mabiran/environode-wl55/CM0/EnviroNode_CM0PLUS/LoRaWAN/App/lora_app.c

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

/* Includes ------------------------------------------------------------------*/
#include "platform.h"
#include "sys_app.h"
#include "lora_app.h"
#include "stm32_seq.h"
#include "stm32_timer.h"
#include "utilities_def.h"
#include "app_version.h"
#include "lorawan_version.h"
#include "subghz_phy_version.h"
#include "lora_info.h"
#include "LmHandler.h"
#include "adc_if.h"
#include "CayenneLpp.h"
#include "sys_sensors.h"
#include "flash_if.h"

/* USER CODE BEGIN Includes */
#include "korero_mailbox.h"
/* USER CODE END Includes */

/* External variables ---------------------------------------------------------*/
/**
  * @brief LoRa State Machine states
  */
typedef enum TxEventType_e
{
  /**
    * @brief Appdata Transmission issue based on timer every TxDutyCycleTime
    */
  TX_ON_TIMER,
  /**
    * @brief Appdata Transmission external event plugged on OnSendEvent( )
    */
  TX_ON_EVENT
} TxEventType_t;

/**
  * LEDs period value of the timer in ms
  */
#define LED_PERIOD_TIME 500

/**
  * Join switch period value of the timer in ms
  */
#define JOIN_TIME 2000

/*---------------------------------------------------------------------------*/
/*                             LoRaWAN NVM configuration                     */
/*---------------------------------------------------------------------------*/
/**
  * @brief LoRaWAN NVM Flash address
  * @note last 2 sector of a 128kBytes device
  */
#define LORAWAN_NVM_BASE_ADDRESS                    ((void *)0x0803F000UL)

/* USER CODE BEGIN PD */
static const char *slotStrings[] = { "1", "2", "C", "C_MC", "P", "P_MC" };
/* USER CODE END PD */

/**
  * @brief  LoRa End Node send request
  */
static void SendTxData(void);

/**
  * @brief  TX timer callback function
  * @param  context ptr of timer context
  */
static void OnTxTimerEvent(void *context);

/**
  * @brief  join event callback function
  * @param  joinParams status of join
  */
static void OnJoinRequest(LmHandlerJoinParams_t *joinParams);

/**
  * @brief callback when LoRaWAN application has sent a frame
  * @brief  tx event callback function
  * @param  params status of last Tx
  */
static void OnTxData(LmHandlerTxParams_t *params);

/**
  * @brief callback when LoRaWAN application has received a frame
  * @param appData data received in the last Rx
  * @param params status of last Rx
  */
static void OnRxData(LmHandlerAppData_t *appData, LmHandlerRxParams_t *params);

/**
  * @brief callback when LoRaWAN Beacon status is updated
  * @param params status of Last Beacon
  */
static void OnBeaconStatusChange(LmHandlerBeaconParams_t *params);

/**
  * @brief callback when system time has been updated
  */
static void OnSysTimeUpdate(void);

/**
  * @brief callback when LoRaWAN application Class is changed
  * @param deviceClass new class
  */
static void OnClassChange(DeviceClass_t deviceClass);

/**
  * @brief  LoRa store context in Non Volatile Memory
  */
static void StoreContext(void);

/**
  * @brief  stop current LoRa execution to switch into non default Activation mode
  */
static void StopJoin(void);

/**
  * @brief  Join switch timer callback function
  * @param  context ptr of Join switch context
  */
static void OnStopJoinTimerEvent(void *context);

/**
  * @brief  Notifies the upper layer that the NVM context has changed
  * @param  state Indicates if we are storing (true) or restoring (false) the NVM context
  */
static void OnNvmDataChange(LmHandlerNvmContextStates_t state);

/**
  * @brief  Store the NVM Data context to the Flash
  * @param  nvm ptr on nvm structure
  * @param  nvm_size number of data bytes which were stored
  */
static void OnStoreContextRequest(void *nvm, uint32_t nvm_size);

/**
  * @brief  Restore the NVM Data context from the Flash
  * @param  nvm ptr on nvm structure
  * @param  nvm_size number of data bytes which were restored
  */
static void OnRestoreContextRequest(void *nvm, uint32_t nvm_size);

/**
  * Will be called each time a Radio IRQ is handled by the MAC layer
  *
  */
static void OnMacProcessNotify(void);

/**
  * @brief Change the periodicity of the uplink frames
  * @param periodicity uplink frames period in ms
  * @note Compliance test protocol callbacks
  */
static void OnTxPeriodicityChanged(uint32_t periodicity);

/**
  * @brief Change the confirmation control of the uplink frames
  * @param isTxConfirmed Indicates if the uplink requires an acknowledgement
  * @note Compliance test protocol callbacks
  */
static void OnTxFrameCtrlChanged(LmHandlerMsgTypes_t isTxConfirmed);

/**
  * @brief Change the periodicity of the ping slot frames
  * @param pingSlotPeriodicity ping slot frames period in ms
  * @note Compliance test protocol callbacks
  */
static void OnPingSlotPeriodicityChanged(uint8_t pingSlotPeriodicity);

/**
  * @brief Will be called to reset the system
  * @note Compliance test protocol callbacks
  */
static void OnSystemReset(void);

/* USER CODE BEGIN PFP */

/**
  * @brief  LED Tx timer callback function
  * @param  context ptr of LED context
  */
static void OnTxTimerLedEvent(void *context);

/**
  * @brief  LED Rx timer callback function
  * @param  context ptr of LED context
  */
static void OnRxTimerLedEvent(void *context);

/**
  * @brief  LED Join timer callback function
  * @param  context ptr of LED context
  */
static void OnJoinTimerLedEvent(void *context);

/**
  * @brief  Periodic poll of the CM4<->CM0+ mailbox; schedules an uplink of the
  *         payload supplied by the CM4 application core.
  * @param  context unused
  */
static void OnMailboxPollTimer(void *context);
static void ProvisionKeys(void);
static void Korero_PublishDevEUI(void);   /* publish DevEUI to mailbox for CM4 */

/* USER CODE END PFP */

/**
  * @brief LoRaWAN default activation type
  */
static ActivationType_t ActivationType = LORAWAN_DEFAULT_ACTIVATION_TYPE;

/**
  * @brief LoRaWAN force rejoin even if the NVM context is restored
  */
static bool ForceRejoin = LORAWAN_FORCE_REJOIN_AT_BOOT;

/**
  * @brief LoRaWAN handler Callbacks
  */
static LmHandlerCallbacks_t LmHandlerCallbacks =
{
  .GetBatteryLevel =              GetBatteryLevel,
  .GetTemperature =               GetTemperatureLevel,
  .GetUniqueId =                  GetUniqueId,
  .GetDevAddr =                   GetDevAddr,
  .OnRestoreContextRequest =      OnRestoreContextRequest,
  .OnStoreContextRequest =        OnStoreContextRequest,
  .OnMacProcess =                 OnMacProcessNotify,
  .OnNvmDataChange =              OnNvmDataChange,
  .OnJoinRequest =                OnJoinRequest,
  .OnTxData =                     OnTxData,
  .OnRxData =                     OnRxData,
  .OnBeaconStatusChange =         OnBeaconStatusChange,
  .OnSysTimeUpdate =              OnSysTimeUpdate,
  .OnClassChange =                OnClassChange,
  .OnTxPeriodicityChanged =       OnTxPeriodicityChanged,
  .OnTxFrameCtrlChanged =         OnTxFrameCtrlChanged,
  .OnPingSlotPeriodicityChanged = OnPingSlotPeriodicityChanged,
  .OnSystemReset =                OnSystemReset,
};

/**
  * @brief LoRaWAN handler parameters
  */
static LmHandlerParams_t LmHandlerParams =
{
  .ActiveRegion =             ACTIVE_REGION,
  .DefaultClass =             LORAWAN_DEFAULT_CLASS,
  .AdrEnable =                LORAWAN_ADR_STATE,
  .IsTxConfirmed =            LORAWAN_DEFAULT_CONFIRMED_MSG_STATE,
  .TxDatarate =               LORAWAN_DEFAULT_DATA_RATE,
  .TxPower =                  LORAWAN_DEFAULT_TX_POWER,
  .PingSlotPeriodicity =      LORAWAN_DEFAULT_PING_SLOT_PERIODICITY,
  .RxBCTimeout =              LORAWAN_DEFAULT_CLASS_B_C_RESP_TIMEOUT
};

/**
  * @brief Type of Event to generate application Tx
  */
/* KoreroNet: event-driven, NOT periodic. Uplinks are triggered by Pi commands
   relayed from CM4 via the shared mailbox (see OnMailboxPollTimer), not a timer. */
static TxEventType_t EventType = TX_ON_EVENT;

/**
  * @brief Timer to handle the application Tx
  */
static UTIL_TIMER_Object_t TxTimer;

/**
  * @brief Tx Timer period
  */
static UTIL_TIMER_Time_t TxPeriodicity = APP_TX_DUTYCYCLE;

/**
  * @brief Join Timer period
  */
static UTIL_TIMER_Object_t StopJoinTimer;

/* USER CODE BEGIN PV */
/**
  * @brief User application buffer
  */
static uint8_t AppDataBuffer[LORAWAN_APP_DATA_BUFFER_MAX_SIZE];

/**
  * @brief User application data structure
  */
static LmHandlerAppData_t AppData = { 0, 0, AppDataBuffer };

/**
  * @brief Specifies the state of the application LED
  */
static uint8_t AppLedStateOn = RESET;

/**
  * @brief Timer to handle the application Tx Led to toggle
  */
static UTIL_TIMER_Object_t TxLedTimer;

/**
  * @brief Timer to handle the application Rx Led to toggle
  */
static UTIL_TIMER_Object_t RxLedTimer;

/**
  * @brief Timer to handle the application Join Led to toggle
  */
static UTIL_TIMER_Object_t JoinLedTimer;

/**
  * Temp buffer to store a FLASH page in RAM when partial replacement is needed
  */
static uint8_t FLASH_RAM_buffer[FLASH_IF_BUFFER_SIZE];

/* KoreroNet inter-core mailbox: poll timer + last-seen request + staged payload */
#define KORERO_MB_POLL_MS   250U
static UTIL_TIMER_Object_t MailboxTimer;
static uint32_t MbLastSeq = 0;
static uint32_t KeyLastSeq = 0;   /* last OTAA-key request seq applied */
static uint8_t  TxPayload[KORERO_MB_MAX_PAYLOAD];
static uint8_t  TxPayloadLen = 0;
static uint8_t  TxPayloadPort = LORAWAN_USER_APP_PORT;
static uint8_t  TxFromMailbox = 0;   /* 1 => SendTxData should send TxPayload */

/* USER CODE END PV */

/* Exported functions ---------------------------------------------------------*/
void LoRaWAN_Init(void)
{
  /* USER CODE BEGIN LoRaWAN_Init_LV */
  uint32_t feature_version = 0UL;
  /* USER CODE END LoRaWAN_Init_LV */

  /* USER CODE BEGIN LoRaWAN_Init_1 */

  /* Get LoRaWAN APP version*/
  APP_LOG(TS_OFF, VLEVEL_M, "APPLICATION_VERSION: V%X.%X.%X\r\n",
          (uint8_t)(APP_VERSION_MAIN),
          (uint8_t)(APP_VERSION_SUB1),
          (uint8_t)(APP_VERSION_SUB2));

  /* Get MW LoRaWAN info */
  APP_LOG(TS_OFF, VLEVEL_M, "MW_LORAWAN_VERSION:  V%X.%X.%X\r\n",
          (uint8_t)(LORAWAN_VERSION_MAIN),
          (uint8_t)(LORAWAN_VERSION_SUB1),
          (uint8_t)(LORAWAN_VERSION_SUB2));

  /* Get MW SubGhz_Phy info */
  APP_LOG(TS_OFF, VLEVEL_M, "MW_RADIO_VERSION:    V%X.%X.%X\r\n",
          (uint8_t)(SUBGHZ_PHY_VERSION_MAIN),
          (uint8_t)(SUBGHZ_PHY_VERSION_SUB1),
          (uint8_t)(SUBGHZ_PHY_VERSION_SUB2));

  /* Get LoRaWAN Link Layer info */
  LmHandlerGetVersion(LORAMAC_HANDLER_L2_VERSION, &feature_version);
  APP_LOG(TS_OFF, VLEVEL_M, "L2_SPEC_VERSION:     V%X.%X.%X\r\n",
          (uint8_t)(feature_version >> 24),
          (uint8_t)(feature_version >> 16),
          (uint8_t)(feature_version >> 8));

  /* Get LoRaWAN Regional Parameters info */
  LmHandlerGetVersion(LORAMAC_HANDLER_REGION_VERSION, &feature_version);
  APP_LOG(TS_OFF, VLEVEL_M, "RP_SPEC_VERSION:     V%X-%X.%X.%X\r\n",
          (uint8_t)(feature_version >> 24),
          (uint8_t)(feature_version >> 16),
          (uint8_t)(feature_version >> 8),
          (uint8_t)(feature_version));

  UTIL_TIMER_Create(&TxLedTimer, LED_PERIOD_TIME, UTIL_TIMER_ONESHOT, OnTxTimerLedEvent, NULL);
  UTIL_TIMER_Create(&RxLedTimer, LED_PERIOD_TIME, UTIL_TIMER_ONESHOT, OnRxTimerLedEvent, NULL);
  UTIL_TIMER_Create(&JoinLedTimer, LED_PERIOD_TIME, UTIL_TIMER_PERIODIC, OnJoinTimerLedEvent, NULL);

  if (FLASH_IF_Init(FLASH_RAM_buffer) != FLASH_IF_OK)
  {
    Error_Handler();
  }

  /* USER CODE END LoRaWAN_Init_1 */

  UTIL_TIMER_Create(&StopJoinTimer, JOIN_TIME, UTIL_TIMER_ONESHOT, OnStopJoinTimerEvent, NULL);

  UTIL_SEQ_RegTask((1 << CFG_SEQ_Task_LmHandlerProcess), UTIL_SEQ_RFU, LmHandlerProcess);

  UTIL_SEQ_RegTask((1 << CFG_SEQ_Task_LoRaSendOnTxTimerOrButtonEvent), UTIL_SEQ_RFU, SendTxData);
  UTIL_SEQ_RegTask((1 << CFG_SEQ_Task_LoRaStoreContextEvent), UTIL_SEQ_RFU, StoreContext);
  UTIL_SEQ_RegTask((1 << CFG_SEQ_Task_LoRaStopJoinEvent), UTIL_SEQ_RFU, StopJoin);
  UTIL_SEQ_RegTask((1 << CFG_SEQ_Task_LoRaProvisionKeys), UTIL_SEQ_RFU, ProvisionKeys);

  /* Init Info table used by LmHandler*/
  LoraInfo_Init();

  /* Init the Lora Stack*/
  LmHandlerInit(&LmHandlerCallbacks, APP_VERSION);

  LmHandlerConfigure(&LmHandlerParams);

  /* USER CODE BEGIN LoRaWAN_Init_2 */
  /* KoreroNet: red join-blink disabled (no flashing LED_RED). Keep it off. */
  /* UTIL_TIMER_Start(&JoinLedTimer); */
  HAL_GPIO_WritePin(LED3_GPIO_Port, LED3_Pin, GPIO_PIN_RESET); /* LED_RED off */

#if defined(REGION_AU915)
  /* KoreroNet: TTN Australia uses AU915 sub-band 2 (FSB2) — 125 kHz channels
     8..15 plus the 500 kHz channel 65. Restrict the channel mask so OTAA join
     requests are sent only on channels the gateway listens to (otherwise the
     node hops all 72 channels and the join is slow/unreliable). */
  {
    static uint16_t Fsb2ChannelsMask[6] = { 0xFF00, 0x0000, 0x0000, 0x0000, 0x0002, 0x0000 };
    MibRequestConfirm_t mibReq;
    mibReq.Type = MIB_CHANNELS_DEFAULT_MASK;
    mibReq.Param.ChannelsDefaultMask = Fsb2ChannelsMask;
    LoRaMacMibSetRequestConfirm(&mibReq);
    mibReq.Type = MIB_CHANNELS_MASK;
    mibReq.Param.ChannelsMask = Fsb2ChannelsMask;
    LoRaMacMibSetRequestConfirm(&mibReq);
    APP_LOG(TS_OFF, VLEVEL_M, "AU915: restricted to sub-band 2 (FSB2)\r\n");
  }
#endif /* REGION_AU915 */

  /* USER CODE END LoRaWAN_Init_2 */

  LmHandlerJoin(ActivationType, ForceRejoin);

  if (EventType == TX_ON_TIMER)
  {
    /* send every time timer elapses */
    UTIL_TIMER_Create(&TxTimer, TxPeriodicity, UTIL_TIMER_ONESHOT, OnTxTimerEvent, NULL);
    UTIL_TIMER_Start(&TxTimer);
  }
  else
  {
  }

  /* USER CODE BEGIN LoRaWAN_Init_Last */
  /* KoreroNet: start polling the CM4<->CM0+ mailbox for uplink commands. */
  MbLastSeq = KORERO_MAILBOX->req_seq;   /* ignore anything already pending */
  UTIL_TIMER_Create(&MailboxTimer, KORERO_MB_POLL_MS, UTIL_TIMER_PERIODIC, OnMailboxPollTimer, NULL);
  UTIL_TIMER_Start(&MailboxTimer);
  Korero_PublishDevEUI();   /* let CM4/Pi read our DevEUI via `nucleo deveui` */
  /* USER CODE END LoRaWAN_Init_Last */
}

/* USER CODE BEGIN PB_Callbacks */

void HAL_GPIO_EXTI_Callback(uint16_t GPIO_Pin)
{
  switch (GPIO_Pin)
  {
    case  BUT1_Pin:
      /* KoreroNet: B1 -> request Raspberry Pi 5V power ON (CM4 drives the opto). */
      if (KORERO_MAILBOX->magic == KORERO_MB_MAGIC)
      {
        KORERO_MAILBOX->pi_pwr_on = 1u;
        __DMB();
        KORERO_MAILBOX->pi_pwr_seq = KORERO_MAILBOX->pi_pwr_seq + 1u;
      }
      break;
    case  BUT2_Pin:
      /* KoreroNet: B2 -> request Raspberry Pi 5V power OFF (opposite of B1). */
      if (KORERO_MAILBOX->magic == KORERO_MB_MAGIC)
      {
        KORERO_MAILBOX->pi_pwr_on = 0u;
        __DMB();
        KORERO_MAILBOX->pi_pwr_seq = KORERO_MAILBOX->pi_pwr_seq + 1u;
      }
      break;
    case  BUT3_Pin:
      UTIL_SEQ_SetTask((1 << CFG_SEQ_Task_LoRaStoreContextEvent), CFG_SEQ_Prio_0);
      break;
    default:
      break;
  }
}

/* USER CODE END PB_Callbacks */

/* USER CODE BEGIN PrFD */

/* Poll the shared mailbox; when CM4 has posted a new command, stage its payload
   and schedule an uplink. Runs in the UTIL_TIMER (LPTIM IRQ) context. */
static void OnMailboxPollTimer(void *context)
{
  volatile KoreroMailbox_t *mb = KORERO_MAILBOX;

  if ((mb->magic == KORERO_MB_MAGIC) && (mb->req_seq != MbLastSeq))
  {
    uint8_t len = mb->len;
    if (len > KORERO_MB_MAX_PAYLOAD)
    {
      len = KORERO_MB_MAX_PAYLOAD;
    }
    for (uint8_t i = 0; i < len; i++)
    {
      TxPayload[i] = mb->payload[i];
    }
    TxPayloadLen  = len;
    TxPayloadPort = (mb->port != 0U) ? mb->port : (uint8_t)LORAWAN_USER_APP_PORT;
    TxFromMailbox = 1;
    MbLastSeq     = mb->req_seq;

    UTIL_SEQ_SetTask((1 << CFG_SEQ_Task_LoRaSendOnTxTimerOrButtonEvent), CFG_SEQ_Prio_0);
  }

  /* New OTAA keys posted by CM4 -> apply them + rejoin (in thread context). */
  if ((mb->magic == KORERO_MB_MAGIC) && (mb->key_seq != KeyLastSeq))
  {
    KeyLastSeq = mb->key_seq;
    UTIL_SEQ_SetTask((1 << CFG_SEQ_Task_LoRaProvisionKeys), CFG_SEQ_Prio_0);
  }
}

/* Publish the radio core's active DevEUI into the mailbox so CM4 can serve it to
   the Pi on demand (`nucleo deveui`) without a reset / boot-log parse. */
static void Korero_PublishDevEUI(void)
{
  volatile KoreroMailbox_t *mb = KORERO_MAILBOX;
  uint8_t eui[8];
  if (LmHandlerGetDevEUI(eui) == LORAMAC_HANDLER_SUCCESS)
  {
    for (uint8_t i = 0; i < 8U; i++) { mb->dev_eui_now[i] = eui[i]; }
    __DMB();
    mb->deveui_ready = 1U;
  }
}

/* Apply the OTAA keys CM4 wrote into the mailbox, then force a re-join. */
static void ProvisionKeys(void)
{
  volatile KoreroMailbox_t *mb = KORERO_MAILBOX;
  uint8_t deveui[8], appeui[8], appkey[16];
  uint8_t i, deveui_nz = 0;

  for (i = 0; i < 8; i++)  { deveui[i] = mb->dev_eui[i]; appeui[i] = mb->join_eui[i]; deveui_nz |= deveui[i]; }
  for (i = 0; i < 16; i++) { appkey[i] = mb->app_key[i]; }

  if (deveui_nz) { LmHandlerSetDevEUI(deveui); }  /* all-zero => keep chip/default DevEUI */
  LmHandlerSetAppEUI(appeui);
  LmHandlerSetKey(APP_KEY, appkey);   /* GenAppKey slot         */
  LmHandlerSetKey(NWK_KEY, appkey);   /* 1.0.x AppKey (TTN)     */

  APP_LOG(TS_OFF, VLEVEL_M, "KEYS: provisioned from CM4; forcing OTAA re-join...\r\n");
  LmHandlerJoin(ActivationType, true);   /* forceRejoin */

  mb->key_ack = KeyLastSeq;
  Korero_PublishDevEUI();   /* DevEUI may have changed (Pi override) */
}

/* KoreroNet: stash a received gateway downlink (port + bytes) into the shared
   mailbox ring so CM4 can serve it to the Pi (`nucleo get downlink`) and apply
   any timetable. Runs in the LoRaMAC RX callback context. */
static void Korero_StoreDownlink(uint8_t port, const uint8_t *buf, uint8_t size)
{
  volatile KoreroMailbox_t *mb = KORERO_MAILBOX;
  if ((mb->magic != KORERO_MB_MAGIC) || (buf == NULL) || (size == 0U)) { return; }
  if (size > KORERO_DL_MAX) { size = KORERO_DL_MAX; }
  uint32_t i = mb->dl_head % KORERO_DL_SLOTS;
  mb->dl_port[i] = port;
  for (uint8_t k = 0; k < size; k++) { mb->dl_data[i][k] = buf[k]; }
  mb->dl_len[i] = size;
  __DMB();                          /* payload visible before the commit       */
  mb->dl_head = mb->dl_head + 1U;   /* commit: CM4 sees it on its next drain    */
}

/* USER CODE END PrFD */

static void OnRxData(LmHandlerAppData_t *appData, LmHandlerRxParams_t *params)
{
  /* USER CODE BEGIN OnRxData_1 */
  uint8_t RxPort = 0;

  if (params != NULL)
  {
    HAL_GPIO_WritePin(LED1_GPIO_Port, LED1_Pin, GPIO_PIN_SET); /* LED_BLUE */

    UTIL_TIMER_Start(&RxLedTimer);

    if (params->IsMcpsIndication)
    {
      if (appData != NULL)
      {
        RxPort = appData->Port;
        if (appData->Buffer != NULL)
        {
          /* EnviroNode: EVERY downlink goes to CM4, whatever port it arrived on.
             The switch below still runs the inherited ST demo behaviour for
             ports 2 and 3, but those two used to `break` without storing, so a
             config string sent on port 2 or 3 was silently swallowed — while
             docs/CONFIG.md promises the "{...}" string is honoured on any port.
             Storing first makes that promise true and costs one ring slot. */
          Korero_StoreDownlink(appData->Port, appData->Buffer, appData->BufferSize);

          switch (appData->Port)
          {
            case LORAWAN_SWITCH_CLASS_PORT:
              /*this port switches the class*/
              if (appData->BufferSize == 1)
              {
                switch (appData->Buffer[0])
                {
                  case 0:
                  {
                    LmHandlerRequestClass(CLASS_A);
                    break;
                  }
                  case 1:
                  {
                    LmHandlerRequestClass(CLASS_B);
                    break;
                  }
                  case 2:
                  {
                    LmHandlerRequestClass(CLASS_C);
                    break;
                  }
                  default:
                    break;
                }
              }
              break;
            case LORAWAN_USER_APP_PORT:
              if (appData->BufferSize == 1)
              {
                AppLedStateOn = appData->Buffer[0] & 0x01;
                if (AppLedStateOn == RESET)
                {
                  APP_LOG(TS_OFF, VLEVEL_H, "LED OFF\r\n");
                  HAL_GPIO_WritePin(LED3_GPIO_Port, LED3_Pin, GPIO_PIN_RESET); /* LED_RED */
                }
                else
                {
                  APP_LOG(TS_OFF, VLEVEL_H, "LED ON\r\n");
                  HAL_GPIO_WritePin(LED3_GPIO_Port, LED3_Pin, GPIO_PIN_SET); /* LED_RED */
                }
              }
              break;

            default:
              /* Already stored above, for every port — nothing extra to do. */
              break;
          }
        }
      }
    }
    if (params->RxSlot < RX_SLOT_NONE)
    {
      APP_LOG(TS_OFF, VLEVEL_H, "###### D/L FRAME:%04d | PORT:%d | DR:%d | SLOT:%s | RSSI:%d | SNR:%d\r\n",
              params->DownlinkCounter, RxPort, params->Datarate, slotStrings[params->RxSlot],
              params->Rssi, params->Snr);
    }
  }
  /* USER CODE END OnRxData_1 */
}

static void SendTxData(void)
{
  /* USER CODE BEGIN SendTxData_1 */
  LmHandlerErrorStatus_t status = LORAMAC_HANDLER_ERROR;
  UTIL_TIMER_Time_t nextTxIn = 0;
  uint8_t mbResult = KORERO_ST_BUSY;

  if (LmHandlerIsBusy() == false)
  {
    uint32_t i;

    if (TxFromMailbox)
    {
      /* KoreroNet: uplink the payload the Pi sent ("nucleo, lorawan: <text>"),
         relayed here by CM4 through the shared mailbox. */
      AppData.Port = TxPayloadPort;
      for (i = 0; i < TxPayloadLen; i++)
      {
        AppData.Buffer[i] = TxPayload[i];
      }
      AppData.BufferSize = TxPayloadLen;
      APP_LOG(TS_ON, VLEVEL_M, "TX (from Pi/CM4): %d bytes on port %d\r\n",
              (int)AppData.BufferSize, (int)AppData.Port);
    }
    else
    {
      /* Fallback (e.g. Nucleo button SW1): a plain "HELLO". */
      static const char helloMsg[] = "HELLO";
      AppData.Port = LORAWAN_USER_APP_PORT;
      for (i = 0; i < (sizeof(helloMsg) - 1U); i++)
      {
        AppData.Buffer[i] = (uint8_t)helloMsg[i];
      }
      AppData.BufferSize = (uint8_t)i;
      APP_LOG(TS_ON, VLEVEL_M, "TX HELLO: %d bytes on port %d\r\n",
              (int)AppData.BufferSize, (int)AppData.Port);
    }

    if ((JoinLedTimer.IsRunning) && (LmHandlerJoinStatus() == LORAMAC_HANDLER_SET))
    {
      UTIL_TIMER_Stop(&JoinLedTimer);
      HAL_GPIO_WritePin(LED3_GPIO_Port, LED3_Pin, GPIO_PIN_RESET); /* LED_RED */
    }

    status = LmHandlerSend(&AppData, LmHandlerParams.IsTxConfirmed, false);
    if (LORAMAC_HANDLER_SUCCESS == status)
    {
      APP_LOG(TS_ON, VLEVEL_L, "SEND REQUEST\r\n");
      mbResult = KORERO_ST_SENT;
    }
    else if (LORAMAC_HANDLER_DUTYCYCLE_RESTRICTED == status)
    {
      nextTxIn = LmHandlerGetDutyCycleWaitTime();
      if (nextTxIn > 0)
      {
        APP_LOG(TS_ON, VLEVEL_L, "Next Tx in  : ~%d second(s)\r\n", (nextTxIn / 1000));
      }
      mbResult = KORERO_ST_BUSY;
    }
    else
    {
      /* Most commonly: not joined yet, or radio error. */
      mbResult = KORERO_ST_NOJOIN;
    }
  }

  /* Acknowledge the mailbox request (so CM4/Pi can see the result). */
  if (TxFromMailbox)
  {
    KORERO_MAILBOX->status  = mbResult;
    KORERO_MAILBOX->ack_seq = MbLastSeq;
    TxFromMailbox = 0;
  }

  if (EventType == TX_ON_TIMER)
  {
    UTIL_TIMER_Stop(&TxTimer);
    UTIL_TIMER_SetPeriod(&TxTimer, MAX(nextTxIn, TxPeriodicity));
    UTIL_TIMER_Start(&TxTimer);
  }

  /* USER CODE END SendTxData_1 */
}

static void OnTxTimerEvent(void *context)
{
  UTIL_SEQ_SetTask((1 << CFG_SEQ_Task_LoRaSendOnTxTimerOrButtonEvent), CFG_SEQ_Prio_0);

  /*Wait for next tx slot*/
  UTIL_TIMER_Start(&TxTimer);
}

/* USER CODE BEGIN PrFD_LedEvents */
static void OnTxTimerLedEvent(void *context)
{
  HAL_GPIO_WritePin(LED2_GPIO_Port, LED2_Pin, GPIO_PIN_RESET); /* LED_GREEN */
}

static void OnRxTimerLedEvent(void *context)
{
  HAL_GPIO_WritePin(LED1_GPIO_Port, LED1_Pin, GPIO_PIN_RESET); /* LED_BLUE */
}

static void OnJoinTimerLedEvent(void *context)
{
  /* KoreroNet: red join-blink disabled — force LED_RED off instead of toggling. */
  (void)context;
  HAL_GPIO_WritePin(LED3_GPIO_Port, LED3_Pin, GPIO_PIN_RESET); /* LED_RED off */
}

/* USER CODE END PrFD_LedEvents */

static void OnTxData(LmHandlerTxParams_t *params)
{
  /* USER CODE BEGIN OnTxData_1 */
  if ((params != NULL))
  {
    /* Process Tx event only if its a mcps response to prevent some internal events (mlme) */
    if (params->IsMcpsConfirm != 0)
    {
      HAL_GPIO_WritePin(LED2_GPIO_Port, LED2_Pin, GPIO_PIN_SET); /* LED_GREEN */
      UTIL_TIMER_Start(&TxLedTimer);

      APP_LOG(TS_OFF, VLEVEL_M, "\r\n###### ========== MCPS-Confirm =============\r\n");
      APP_LOG(TS_OFF, VLEVEL_H, "###### U/L FRAME:%04d | PORT:%d | DR:%d | PWR:%d", params->UplinkCounter,
              params->AppData.Port, params->Datarate, params->TxPower);

      APP_LOG(TS_OFF, VLEVEL_H, " | MSG TYPE:");
      if (params->MsgType == LORAMAC_HANDLER_CONFIRMED_MSG)
      {
        APP_LOG(TS_OFF, VLEVEL_H, "CONFIRMED [%s]\r\n", (params->AckReceived != 0) ? "ACK" : "NACK");
      }
      else
      {
        APP_LOG(TS_OFF, VLEVEL_H, "UNCONFIRMED\r\n");
      }
    }
  }
  /* USER CODE END OnTxData_1 */
}

static void OnJoinRequest(LmHandlerJoinParams_t *joinParams)
{
  /* USER CODE BEGIN OnJoinRequest_1 */
  if (joinParams != NULL)
  {
    if (joinParams->Status == LORAMAC_HANDLER_SUCCESS)
    {
      UTIL_TIMER_Stop(&JoinLedTimer);
      HAL_GPIO_WritePin(LED3_GPIO_Port, LED3_Pin, GPIO_PIN_RESET); /* LED_RED */

      /* KoreroNet: tell CM4 (and thus the Pi) we joined, so it can send. */
      if (KORERO_MAILBOX->magic == KORERO_MB_MAGIC) { KORERO_MAILBOX->joined = 1u; }

      /* EnviroNode r31: persist the LoRaMAC context (incl. the LoRaWAN-1.0.4
         DevNonce counter) after every successful join. Without this the nonce
         restarted at 1 on each reset and TTN silently rejected every join as a
         replay until the counter climbed past its last accepted value - the
         ST example only stored context on a button press. */
      UTIL_SEQ_SetTask((1 << CFG_SEQ_Task_LoRaStoreContextEvent), CFG_SEQ_Prio_0);
      APP_LOG(TS_OFF, VLEVEL_M, "\r\n###### = JOINED = ");
      if (joinParams->Mode == ACTIVATION_TYPE_ABP)
      {
        APP_LOG(TS_OFF, VLEVEL_M, "ABP ======================\r\n");
      }
      else
      {
        APP_LOG(TS_OFF, VLEVEL_M, "OTAA =====================\r\n");
      }
    }
    else
    {
      /* KoreroNet: clear the join flag so CM4/Pi see we are not joined. */
      if (KORERO_MAILBOX->magic == KORERO_MB_MAGIC) { KORERO_MAILBOX->joined = 0u; }
      APP_LOG(TS_OFF, VLEVEL_M, "\r\n###### = JOIN FAILED\r\n");
    }

    APP_LOG(TS_OFF, VLEVEL_H, "###### U/L FRAME:JOIN | DR:%d | PWR:%d\r\n", joinParams->Datarate, joinParams->TxPower);
  }
  /* USER CODE END OnJoinRequest_1 */
}

static void OnBeaconStatusChange(LmHandlerBeaconParams_t *params)
{
  /* USER CODE BEGIN OnBeaconStatusChange_1 */
  if (params != NULL)
  {
    switch (params->State)
    {
      default:
      case LORAMAC_HANDLER_BEACON_LOST:
      {
        APP_LOG(TS_OFF, VLEVEL_M, "\r\n###### BEACON LOST\r\n");
        break;
      }
      case LORAMAC_HANDLER_BEACON_RX:
      {
        APP_LOG(TS_OFF, VLEVEL_M,
                "\r\n###### BEACON RECEIVED | DR:%d | RSSI:%d | SNR:%d | FQ:%d | TIME:%d | DESC:%d | "
                "INFO:02X%02X%02X %02X%02X%02X\r\n",
                params->Info.Datarate, params->Info.Rssi, params->Info.Snr, params->Info.Frequency,
                params->Info.Time.Seconds, params->Info.GwSpecific.InfoDesc,
                params->Info.GwSpecific.Info[0], params->Info.GwSpecific.Info[1],
                params->Info.GwSpecific.Info[2], params->Info.GwSpecific.Info[3],
                params->Info.GwSpecific.Info[4], params->Info.GwSpecific.Info[5]);
        break;
      }
      case LORAMAC_HANDLER_BEACON_NRX:
      {
        APP_LOG(TS_OFF, VLEVEL_M, "\r\n###### BEACON NOT RECEIVED\r\n");
        break;
      }
    }
  }
  /* USER CODE END OnBeaconStatusChange_1 */
}

static void OnSysTimeUpdate(void)
{
}

static void OnClassChange(DeviceClass_t deviceClass)
{
  /* USER CODE BEGIN OnClassChange_1 */
  APP_LOG(TS_OFF, VLEVEL_M, "Switch to Class %c done\r\n", "ABC"[deviceClass]);
  /* USER CODE END OnClassChange_1 */
}

static void OnMacProcessNotify(void)
{
  UTIL_SEQ_SetTask((1 << CFG_SEQ_Task_LmHandlerProcess), CFG_SEQ_Prio_0);

}

static void OnTxPeriodicityChanged(uint32_t periodicity)
{
  TxPeriodicity = periodicity;

  if (TxPeriodicity == 0)
  {
    /* Revert to application default periodicity */
    TxPeriodicity = APP_TX_DUTYCYCLE;
  }

  /* Update timer periodicity */
  UTIL_TIMER_Stop(&TxTimer);
  UTIL_TIMER_SetPeriod(&TxTimer, TxPeriodicity);
  UTIL_TIMER_Start(&TxTimer);
}

static void OnTxFrameCtrlChanged(LmHandlerMsgTypes_t isTxConfirmed)
{
  LmHandlerParams.IsTxConfirmed = isTxConfirmed;
}

static void OnPingSlotPeriodicityChanged(uint8_t pingSlotPeriodicity)
{
  LmHandlerParams.PingSlotPeriodicity = pingSlotPeriodicity;
}

static void OnSystemReset(void)
{
  if ((LORAMAC_HANDLER_SUCCESS == LmHandlerHalt()) && (LmHandlerJoinStatus() == LORAMAC_HANDLER_SET))
  {
    NVIC_SystemReset();
  }
}

static void StopJoin(void)
{
  /* USER CODE BEGIN StopJoin_1 */
  HAL_GPIO_WritePin(LED1_GPIO_Port, LED1_Pin, GPIO_PIN_SET); /* LED_BLUE */
  HAL_GPIO_WritePin(LED2_GPIO_Port, LED2_Pin, GPIO_PIN_SET); /* LED_GREEN */
  HAL_GPIO_WritePin(LED3_GPIO_Port, LED3_Pin, GPIO_PIN_RESET); /* KoreroNet: keep LED_RED off */
  /* USER CODE END StopJoin_1 */

  UTIL_TIMER_Stop(&TxTimer);

  if (LORAMAC_HANDLER_SUCCESS != LmHandlerStop())
  {
    APP_LOG(TS_OFF, VLEVEL_M, "LmHandler Stop on going ...\r\n");
  }
  else
  {
    APP_LOG(TS_OFF, VLEVEL_M, "LmHandler Stopped\r\n");
    if (LORAWAN_DEFAULT_ACTIVATION_TYPE == ACTIVATION_TYPE_ABP)
    {
      ActivationType = ACTIVATION_TYPE_OTAA;
      APP_LOG(TS_OFF, VLEVEL_M, "LmHandler switch to OTAA mode\r\n");
    }
    else
    {
      ActivationType = ACTIVATION_TYPE_ABP;
      APP_LOG(TS_OFF, VLEVEL_M, "LmHandler switch to ABP mode\r\n");
    }
    LmHandlerConfigure(&LmHandlerParams);
    LmHandlerJoin(ActivationType, true);
    UTIL_TIMER_Start(&TxTimer);
  }
  UTIL_TIMER_Start(&StopJoinTimer);
}

static void OnStopJoinTimerEvent(void *context)
{
  if (ActivationType == LORAWAN_DEFAULT_ACTIVATION_TYPE)
  {
    UTIL_SEQ_SetTask((1 << CFG_SEQ_Task_LoRaStopJoinEvent), CFG_SEQ_Prio_0);
  }
  /* USER CODE BEGIN OnStopJoinTimerEvent_Last */
  HAL_GPIO_WritePin(LED1_GPIO_Port, LED1_Pin, GPIO_PIN_RESET); /* LED_BLUE */
  HAL_GPIO_WritePin(LED2_GPIO_Port, LED2_Pin, GPIO_PIN_RESET); /* LED_GREEN */
  HAL_GPIO_WritePin(LED3_GPIO_Port, LED3_Pin, GPIO_PIN_RESET); /* LED_RED */
  /* USER CODE END OnStopJoinTimerEvent_Last */
}

static void StoreContext(void)
{
  LmHandlerErrorStatus_t status = LORAMAC_HANDLER_ERROR;

  status = LmHandlerNvmDataStore();

  if (status == LORAMAC_HANDLER_NVM_DATA_UP_TO_DATE)
  {
    APP_LOG(TS_OFF, VLEVEL_M, "NVM DATA UP TO DATE\r\n");
  }
  else if (status == LORAMAC_HANDLER_ERROR)
  {
    APP_LOG(TS_OFF, VLEVEL_M, "NVM DATA STORE FAILED\r\n");
  }
}

static void OnNvmDataChange(LmHandlerNvmContextStates_t state)
{
  if (state == LORAMAC_HANDLER_NVM_STORE)
  {
    APP_LOG(TS_OFF, VLEVEL_M, "NVM DATA STORED\r\n");
  }
  else
  {
    APP_LOG(TS_OFF, VLEVEL_M, "NVM DATA RESTORED\r\n");
  }
}

static void OnStoreContextRequest(void *nvm, uint32_t nvm_size)
{
  FLASH_IF_Write(LORAWAN_NVM_BASE_ADDRESS, (const void *)nvm, nvm_size);

}

static void OnRestoreContextRequest(void *nvm, uint32_t nvm_size)
{
  FLASH_IF_Read(nvm, LORAWAN_NVM_BASE_ADDRESS, nvm_size);
}
