mabiran/environode-wl55/CM4/EnviroNode_CM4/Core/WL55JC1/Src/stm32wlxx_it.c

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

/* Includes ------------------------------------------------------------------*/
#include "main.h"
#include "stm32wlxx_it.h"
/* USER CODE BEGIN Includes */
#include "pins_config.h"                 /* ENV_RAIN_Pin / ENV_WIND_Pin       */
#include "sensors/pulse_counter.h"       /* pulse_rain_isr                    */
#include "rtc.h"                         /* hrtc — RTC wake-up from STOP2     */
/* USER CODE END Includes */

/* External variables --------------------------------------------------------*/
extern UART_HandleTypeDef huart1;
extern UART_HandleTypeDef huart2;
/******************************************************************************/
/*           Cortex Processor Interruption and Exception Handlers          */
/******************************************************************************/
/**
  * @brief This function handles Non maskable interrupt.
  */
void NMI_Handler(void)
{
  /* USER CODE BEGIN NonMaskableInt_IRQn 1 */
   while (1)
  {
  }
  /* USER CODE END NonMaskableInt_IRQn 1 */
}

/**
  * @brief This function handles Hard fault interrupt.
  */
void HardFault_Handler(void)
{
  while (1)
  {
  }
}

/**
  * @brief This function handles Memory management fault.
  */
void MemManage_Handler(void)
{
  while (1)
  {
  }
}

/**
  * @brief This function handles Prefetch fault, memory access fault.
  */
void BusFault_Handler(void)
{
  while (1)
  {
  }
}

/**
  * @brief This function handles Undefined instruction or illegal state.
  */
void UsageFault_Handler(void)
{
  while (1)
  {
  }
}

/**
  * @brief This function handles System service call via SWI instruction.
  */
void SVC_Handler(void)
{
}

/**
  * @brief This function handles Debug monitor.
  */
void DebugMon_Handler(void)
{
}

/**
  * @brief This function handles Pendable request for system service.
  */
void PendSV_Handler(void)
{
}

/**
  * @brief This function handles System tick timer.
  */
void SysTick_Handler(void)
{
  HAL_IncTick();
}

/******************************************************************************/
/* STM32WLxx Peripheral Interrupt Handlers                                    */
/* Add here the Interrupt Handlers for the used peripherals.                  */
/* For the available peripheral interrupt handler names,                      */
/* please refer to the startup file (startup_stm32wlxx.s).                    */
/******************************************************************************/

/**
  * @brief This function handles the RTC wake-up timer interrupt.
  *
  * The only job is to exist: it is what ends a STOP2 nap
  * (envnode_power.c). The HAL clears the flag and calls the
  * HAL_RTCEx_WakeUpTimerEventCallback, which this firmware does not override
  * because nothing needs doing beyond waking up.
  */
void RTC_WKUP_IRQHandler(void)
{
  HAL_RTCEx_WakeUpTimerIRQHandler(&hrtc);
}

/**
  * @brief This function handles EXTI line3 interrupt — rain tipping bucket (PB3).
  */
void EXTI3_IRQHandler(void)
{
  HAL_GPIO_EXTI_IRQHandler(ENV_RAIN_Pin);
}

/**
  * @brief This function handles USART1 Interrupt.
  */
void USART1_IRQHandler(void)
{
  HAL_UART_IRQHandler(&huart1);
}

/**
  * @brief This function handles USART2 Interrupt (ST-Link VCP console).
  */
void USART2_IRQHandler(void)
{
  HAL_UART_IRQHandler(&huart2);
}

/* USER CODE BEGIN 1 */

/**
  * @brief  GPIO EXTI line detection callback — routes the rain/wind edges to the
  *         pulse counters. Both handlers only touch volatile counters, so they
  *         stay short enough to run at low priority alongside the UART console.
  * @param  GPIO_Pin  pin that triggered the interrupt.
  */
void HAL_GPIO_EXTI_Callback(uint16_t GPIO_Pin)
{
  switch (GPIO_Pin) {
    case ENV_RAIN_Pin: pulse_rain_isr(); break;   /* PB3 / Arduino D3 */
    default: break;
  }
}

/* USER CODE END 1 */
