mabiran/environode-wl55/CM4/EnviroNode_CM4/Core/WL55JC1/Inc/i2c.h

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
/* Define to prevent recursive inclusion -------------------------------------*/
#ifndef __I2C_H__
#define __I2C_H__

#ifdef __cplusplus
extern "C" {
#endif

/* Includes ------------------------------------------------------------------*/
#include "main.h"

extern I2C_HandleTypeDef hi2c1;
extern I2C_HandleTypeDef hi2c2;

/* USER CODE BEGIN Private defines */
/* EnviroNode: two I2C buses because both BME280s answer at 0x76/0x77.
     I2C1 = PA9 SCL / PA10 SDA  -> hand-wired to the board pins (BME280 #2)
     I2C2 = PA12 SCL / PA11 SDA -> Arduino D15/D14, i.e. the Grove shield's
                                   I2C sockets (BME280 #1 + INA219)
   See docs/PINOUT.md. */
/* USER CODE END Private defines */

void MX_I2C1_Init(void);
void MX_I2C2_Init(void);

/* USER CODE BEGIN Prototypes */

/** Unwedge a BUSY-latched I2C2 (9 SCL clocks + STOP, then re-init) and report
 *  whether SDA reads free. Cheap and safe on a healthy bus — see i2c.c. */
int I2C2_BusRecover(void);

/* USER CODE END Prototypes */

#ifdef __cplusplus
}
#endif

#endif /* __I2C_H__ */
