mabiran/environode-wl55/CM4/EnviroNode_CM4/Core/WL55JC1/Src/spi.c

/**
  ******************************************************************************
  * @file    spi.c
  * @brief   SPI1 configuration for the MAX31865 PT1000 front-end.
  *
  *          PA5 SCK (D13) / PA6 MISO (D12) / PA7 MOSI (D11), software CS on PA4
  *          (D10, configured in gpio.c). SPI mode 1 (CPOL=0, CPHA=1), MSB first,
  *          8-bit. Baud = PCLK2/8 = 16 MHz / 8 = 2 MHz, comfortably under the
  *          MAX31865's 5 MHz ceiling and tolerant of a long RTD harness.
  ******************************************************************************
  */
/* Includes ------------------------------------------------------------------*/
#include "spi.h"

SPI_HandleTypeDef hspi1;

/* SPI1 init function */
void MX_SPI1_Init(void)
{
  hspi1.Instance = SPI1;
  hspi1.Init.Mode = SPI_MODE_MASTER;
  hspi1.Init.Direction = SPI_DIRECTION_2LINES;
  hspi1.Init.DataSize = SPI_DATASIZE_8BIT;
  hspi1.Init.CLKPolarity = SPI_POLARITY_LOW;      /* CPOL = 0 */
  hspi1.Init.CLKPhase = SPI_PHASE_2EDGE;          /* CPHA = 1 -> SPI mode 1 */
  hspi1.Init.NSS = SPI_NSS_SOFT;                  /* CS handled in software  */
  hspi1.Init.BaudRatePrescaler = SPI_BAUDRATEPRESCALER_8;   /* 16 MHz/8 = 2 MHz */
  hspi1.Init.FirstBit = SPI_FIRSTBIT_MSB;
  hspi1.Init.TIMode = SPI_TIMODE_DISABLE;
  hspi1.Init.CRCCalculation = SPI_CRCCALCULATION_DISABLE;
  hspi1.Init.CRCPolynomial = 7;
  hspi1.Init.CRCLength = SPI_CRC_LENGTH_DATASIZE;
  hspi1.Init.NSSPMode = SPI_NSS_PULSE_DISABLE;
  if (HAL_SPI_Init(&hspi1) != HAL_OK)
  {
    Error_Handler();
  }
}

void HAL_SPI_MspInit(SPI_HandleTypeDef* spiHandle)
{
  GPIO_InitTypeDef GPIO_InitStruct = {0};
  if(spiHandle->Instance==SPI1)
  {
    /* SPI1 clock enable */
    __HAL_RCC_SPI1_CLK_ENABLE();

    __HAL_RCC_GPIOA_CLK_ENABLE();
    /**SPI1 GPIO Configuration
    PA5      ------> SPI1_SCK    (Arduino D13)
    PA6      ------> SPI1_MISO   (Arduino D12)
    PA7      ------> SPI1_MOSI   (Arduino D11)
    */
    GPIO_InitStruct.Pin = GPIO_PIN_5|GPIO_PIN_6|GPIO_PIN_7;
    GPIO_InitStruct.Mode = GPIO_MODE_AF_PP;
    GPIO_InitStruct.Pull = GPIO_NOPULL;
    GPIO_InitStruct.Speed = GPIO_SPEED_FREQ_HIGH;
    GPIO_InitStruct.Alternate = GPIO_AF5_SPI1;
    HAL_GPIO_Init(GPIOA, &GPIO_InitStruct);
  }
}

void HAL_SPI_MspDeInit(SPI_HandleTypeDef* spiHandle)
{
  if(spiHandle->Instance==SPI1)
  {
    /* Peripheral clock disable */
    __HAL_RCC_SPI1_CLK_DISABLE();

    HAL_GPIO_DeInit(GPIOA, GPIO_PIN_5|GPIO_PIN_6|GPIO_PIN_7);
  }
}
