mabiran/environode-wl55/(commit log)

2026-07-28 Initial scaffold: EnviroNode-WL55 — WL55JC1 + LoRaWAN agrometeorological node
    Migrated the dual-core STM32WL55JC + LoRaWAN skeleton from KoreroNet 2 (CM4 app + CM0+ radio, SRAM2 mailbox, OTAA, backup-reg persistence, UART command server, event log, IWDG). Renamed KN-1.1_* -> EnviroNode_*; both cores build green. Added design ground truth: docs/PINOUT.md (sensor->peripheral map), docs/PAYLOAD.md (uplink FPort1 + downlink FPort10), ARCHITECTURE, ROADMAP, README, CLAUDE.md. CM4 main.c is the inherited base, marked for progressive replacement with sensor-sampling + payload logic.
    [adc.c, adc.h, battery_adc.c, battery_adc.h, battery_flow.c, battery_flow.h]
2026-07-28 Add CM4 sensor module skeletons + SENSORS.md (Phase 2 scaffold)
    Shared contract (envnode_sensors.h) + fully-implemented 30-byte uplink packer (envnode_payload.c) per docs/PAYLOAD.md + downlink dispatch stub. Driver skeletons: bme280 (I2C, x2 buses), max31865 (SPI PT1000, 4.02k Rref), analog_sensors (soil/leaf/battery/wind-dir ADC), pulse_counter (rain+wind, debounced, functionally complete). docs/SENSORS.md bring-up guide. Files not yet wired into CMakeLists (build stays green until Phase 1 .ioc exists).
2026-07-30 Sensor set config string, STOP2 sleep, LWS + Davis 7911 wiring
    Replaces the inherited KoreroNet application logic with the EnviroNode
    sensor path, and brings the node up on hardware.
    Application:
    - Remove all Raspberry Pi, recording-timetable and acoustic-detection code
    (main.c 3305 -> ~2200 lines). No Pi, no audio, no timetable in this project.
    - Sensor-set config string {LW,T1,T2,SM,ST,WS,WD,R,<1..999>} replaces the
    timetable: selects what to measure and how often, over a LoRaWAN downlink
    (any FPort, first byte '{') or the console. All-or-nothing validation,
    replace-vs-edit semantics, persisted in flash. See docs/CONFIG.md.
    - FPort-10 binary command table wired and auto-applied fr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
    [adc.c, adc.h, analog_sensors.c, analog_sensors.h, battery_adc.c, battery_flow.c, bme280.c, bme280.h]
2026-08-03 Wind speed by ADC burst sampling; INA219 for battery; switched sensor rail
    Wind speed (Davis 7911) moves off EXTI onto ADC_IN1 (PB14/A4), sampled at
    ~1 kHz for 3 s per cycle and counted in software.
    Why: a contact closure carries no voltage proportional to speed, and with
    passive parts frequency cannot be converted to voltage (an RC average
    follows duty cycle, not frequency). Counting is the only option, and doing
    it by interrupt pinned the core awake for the whole interval - an estimated
    ~50-60 mAh/day, roughly 10x the vane pot and pull-up combined. A burst runs
    inside the cycle's existing awake window.
    - SENSOR_EXTI_COUNTED is now rain only, so selecting WS no longer blocks
    STOP2 sleep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
    [adc.c, adc.h, analog_sensors.c, analog_sensors.h, envnode_config.h, envnode_sensors.c, envnode_sensorset.c, envnode_sensorset.h]
2026-08-11 Offline timestamped sensor log in flash; nucleo log dump = CSV
    Every measurement cycle now appends {RTC epoch2000 + the 30-byte frame,
    verbatim} to a flash ring in pages 55-61 (14 KB reserved by the linker,
    FLASH 124K -> 110K). 357 records; when full the oldest page (51 records)
    is erased and logging continues. ~3.7 days at the 15-min field interval.
    - The append runs BEFORE any radio involvement: a node that never joined
    still logs, and the occasional page erase cannot land in an RX window.
    - Torn writes fail their checksum and are skipped; the head is re-found
    by newest-timestamp scan at boot.
    - Console: nucleo log / log dump [n] / log erase. The dump decodes the
    frame with the PAYL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
    [envnode_log.c, envnode_log.h, main.c]
2026-08-11 SD SPI driver (programmed, dormant) + MASTER.md thesis document
    - sd_spi.{h,c}: full SPI-mode SD bring-up (CMD0/8/ACMD41/58, SDHC/SDSC
    addressing, CSD capacity, block read/write). Compiled but NOT in
    service: `nucleo sd` probes and reports; nothing logs to card. CS on
    D2/PB12, configured only on first probe. Init at 250 kHz, always
    restores the MAX31865's 2 MHz bus.
    - LOGBOOK §12A: the enable plan (FatFs vendoring, the ~7 KB flash-budget
    constraint and the ring-shrink answer to it, daily CSV files, fallback
    to the flash ring on card failure) plus required 3.3 V-native breakout
    and decoupling.
    - docs/MASTER.md: thesis-style master document - abstract, motivation,
    architecture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
    [main.c, sd_spi.c, sd_spi.h]
2026-08-11 ARCHITECTURE.md rewritten as the program-flow document (LOGBOOK r15)
    Audit found it still at Phase-0: RTC-register persistence (flash since
    r5), ISR-counted wind (burst since r12), dead function names. Rewritten
    from current source: 10-step boot walkthrough with console evidence, the
    LoRaWAN identity chain (CM0+ table is noise; CM4: backup regs -> flash
    page 63 -> compiled placeholder), main-loop tick order, measurement and
    downlink flows, sleep cycle, persistence map, final reuse map.
2026-08-11 Staleness sweep: sleep/wind/battery claims corrected corpus-wide (r16)
    CLAUDE.md, README, ROADMAP still said STOP2 sleep was 'still to do'
    (done since r5, hardware-verified); CONFIG.md and both peripheral
    summaries still had wind on EXTI5/PB5 and battery on IN1 (burst on
    A4/IN1 and battery on IN0 since r12). Sweep-for-the-old-fact added to
    the logbook's mandatory verification steps.
2026-08-12 SD CSV logging + CONFIG.INI provisioning (FatFs, LOGBOOK r17)
    FatFs R0.12c (minimal profile, ff.c at -Os), diskio glue onto sd_spi,
    per-reading CSV append with daily YYYYMMDD.CSV rotation and f_sync per
    row; one shared row formatter with the console dump. CONFIG.INI on the
    card (appkey/deveui/joineui) outranks every stored identity and persists
    only when different. Flash ring shrunk 7->3 pages (153 records, FLASH
    118K) per the SS12A plan; ring remains the card-failed fallback.
    Parser proven by selftest vectors (pure function, no card needed); the
    mount/write path awaits the board + breakout. Build green, ~5 KB
    headroom. Docs: LOGBOOK r17, ARCHITECTURE identity chain now four-deep,
    CLAUDE.md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
    [envnode_diskio.c, envnode_log.c, envnode_log.h, envnode_sdlog.c, envnode_sdlog.h, main.c]
2026-08-12 SD bring-up (CS on D5) + Decagon 10HS soil moisture on A1 (LOGBOOK r18+r19)
    r18 — the SD card answered after four fixes: SPI mode 0 per transaction,
    a dead card exposed by the new CMD0 R1 trace, decoupling caps fitted, and
    the CS wire found on D5/PB8 via the new `nucleo cshunt` input-pulldown
    scan; firmware follows the joint. FAT32-only documented (exFAT compiled
    out). B1/B2 buttons toggle sleep. MAX31865 dropped from this node.
    r19 — Decagon 10HS (Solem EC-10 HS) on A1: SM joins the default set,
    console prints counts+mV (output 300-1250 mV regulated, independent of
    excitation), 12 mA supply from the switched rail only. Docs: SENSORS §3
    rewritten, PINOUT + assembly bill + decision regi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
    [adc.h, analog_sensors.c, envnode_config.h, main.c, sd_spi.c, sd_spi.h]
2026-08-12 10HS figures verified against the manual (local copy added); 0-50 C note
    Wire colours confirmed from the manual's own CR10X listing (white =
    excitation, red = Vout, bare = gnd); spec block matched every documented
    number verbatim. New: operating range 0-50 C (not rated for frozen soil)
    in SENSORS.md par.3 + r19; 10HS_Manual.pdf now in the repo root (R13).
2026-08-13 PT1000 soil temp via ~900 ohm divider on A2 (LOGBOOK r20); 10HS live-verified
    The dropped MAX31865's job is done by one resistor: 3V3-[900R]-A2-[PT1000]-GND,
    ratiometric off the ADC's own reference (R = Rs*c/(4095-c)), converted by the
    same CVD code (pt1000_ohms_to_celsius now exported). PA10 is muxed from I2C1
    SDA per read; T2 is electrically unusable while the divider is fitted.
    Hardware-verified: 19.5-20.4 C bench. Accuracy rides on the measured series
    resistor (~0.26 C/ohm -> ANALOG_RTD_SERIES_OHMS). Decision D-29.
    Also r20: 10HS verified end-to-end (stable 550 counts / 443 mV after a
    marginal socket contact showed the floating-pin signature); RTC re-set after
    power-down; relocated flas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
2026-08-13 Rain 0.2 mm/tip live on D3; wind set enabled; watch.ps1 bench dashboard (r21)
    Rain wire found on D7 via cshunt, moved to D3, first tip = 0.20 mm.
    {SM,ST,WS,WD,R,1} running: vane stable ~165 deg resting, 3 s burst sampler
    verified at 0.00 m/s stationary. watch.ps1 polls `nucleo sensors` for a
    live terminal view (ASCII-only: PS 5.1 reads unmarked scripts as ANSI).
2026-08-17 INA219 battery V+I on every uplink: frame fmt 0x02, 32 bytes (LOGBOOK r22)
    batt_mA (i16, discharge positive, 0x7FFF = no INA219) appended at offset
    30; all prior offsets unchanged. Selftest packer vector extended (passing
    byte-exact on hardware); TTN decoder accepts fmt 0x01 and 0x02. CSV gains
    a batt_mA column in the flash dump and SD file; flash-ring record now
    carries the 32-byte frame (old records age out via checksum). INA219 init
    probes 0x45 then 0x40. Battery model corrected to the fitted pack: 1S
    Li-ion 2P (2x6600 mAh = 13.2 Ah, 4.2 V full / 3.0 V empty) replacing the
    inherited 4S LiFePO4 constants. Live-verified: 4.084 V, +118 mA
    discharging. Console batt line now prints V, mA and c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
    [envnode_log.c, envnode_log.h, envnode_payload.c, envnode_payload.h, envnode_sensors.c, envnode_sensors.h, main.c, pins_config.h]
2026-08-18 I2C2 self-healing at 100 kHz; power stats fixed; flash.ps1 builds by default (r23)
    The worked-then-vanished INA219: (1) STM32 I2C BUSY-flag lockup on the
    marginal bus - new I2C2_BusRecover() (9 SCL clocks + STOP + re-init) runs
    automatically on a failed battery read and before every scan; (2) I2C2
    dropped 400 kHz -> 100 kHz standard mode (0x30420F13) - 5/5 clean reads
    since; (3) nucleo power stats used a hardcoded 0x45 while the fitted
    module straps 0x40 - it now follows the address init discovered; the
    coulomb seed moved after sensor init and soc_from_voltage got a 1S
    Li-ion curve (was 4S LiFePO4, pinned SoC at 0%). Verified: 4.07 V,
    +0.12 A, SoC 86%, 0.5 W discharge, stable across repeated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
    [envnode_sensors.c, envnode_sensors.h, i2c.h, main.c]
2026-08-18 Coulomb counter 100% re-anchor fixed for 1S (LOGBOOK r24)
    End-of-charge detection used a local hardcoded 14.2 V (4S leftover the
    r22 sweep missed), so the counter could never re-zero at full on the 1S
    pack. Now CHARGE_VOLTAGE_THRESHOLD_V (4.15 V) + C/80 tail (165 mA)
    derived from BATTERY_NOMINAL_mAh.
    [main.c]
2026-08-18 nucleo sd format (on-node FAT32 mkfs); UM2592 p.23 field-power notes (r25)
    _USE_MKFS on, GET_SECTOR_COUNT added to diskio (capacity from CSD), IWDG
    fed per block so a multi-minute format survives the 15 s watchdog.
    Verified live: 7535 MB card formatted ~45 s, remounted, SDLOG active.
    Also converts factory-exFAT >=64 GB cards to FAT32 without a PC.
    Flash budget now ~0.6 KB - next feature needs another -Os file.
    UM2592 Rev 4 p.23 (rendered from the image-only local PDF via WinRT):
    STD_ALONE_5V on CN11 pin1/2 + ALONE jumper leaves the STLINK-V3E
    unpowered; removing the six JP8 jumpers + JP7 gives zero debugger
    leakage. Logged in r25 for the field-power procedure.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
    [envnode_diskio.c, envnode_sdlog.c, envnode_sdlog.h, main.c]
2026-08-18 Status LED on D6 (blink language) + thesis-grade handover sweep (r26+r27)
    r26: envnode_led.{h,c} on PB10/D6 - solid=boot, 1/2/3 flashes =
    joined/no-join/fault, pulse=TX, dark=asleep (pattern generator polls the
    HAL tick from the main loop, so STOP2 silences it by construction; sleep
    path forces the pin dark). Flash budget restored to ~1.9 KB by moving
    envnode_sensorset.c + envnode_log.c to -Os.
    r27: the whole doc corpus audited against source by six parallel
    reviewers; every confirmed finding fixed. Highlights: LOGBOOK Table 4 /
    Figure 5 / flash figures (118K, 0x0801D800) / Table 9 (+9 commands) /
    quick start / CSV schema / field-power procedure / serial how-to / TTN
    exact values (MAC 1.0.4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
    [envnode_led.c, envnode_led.h, envnode_power.c, main.c]
2026-08-24 Full-system enclosure test (LOGBOOK r28): ST/T2 conflict root-caused, EOC fix
    Every sensor wired and read: T1, SM, LW, WD, INA219, SD all live; ST read
    58 C in a 20 C room and T2 was marginal - one wire: BME280 #2's SDA pull-up
    parallels the PT1000 divider's 900 R on A2/PA10 (755 R effective) and the
    divider drags SDA below the BME's V_IH. Added ENVNODE_RTD_ON_A5 (divider on
    the free A5/PB13, no muxing, no conflict; default 0 until the wire moves)
    and ENVNODE_BATT_DIVIDER_FITTED (0, fallback read compiled out).
    End-of-charge now requires net current <= +20 mA (charging/zero), not just
    |I| <= C/80 - a 4.2 V pack discharging 108 mA had been marked FULL.
    Erratum: r22's 'no log erase needed af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
    [analog_sensors.c, analog_sensors.h, main.c]
2026-08-24 PT1000 divider on PA15 (morpho CN7 pin 17); first all-green frame (r29)
    ENVNODE_RTD_PIN selects A2 (muxed legacy) / A5 / PA15; as built = PA15,
    forced from its JTDI-pull-up reset state to analog per read. Verified:
    19.8 C, rtd raw 2231 (the predicted count), air2 reading alongside, and
    the node's first status 0x7F frame - every sensor OK, no fault. A5
    attempt read hard 0 V (cause not established); recorded honestly.
2026-08-24 r29 remainder: firmware + docs for the PA15 divider (staged file-by-file)
    OneDrive placeholder hydration workaround - bulk git add hit
    mmap-invalid-argument; individual adds after a full read succeed.
    [analog_sensors.c, analog_sensors.h, main.c]
2026-08-25 r29 remainder 2/2: adc.h + CONFIG.md + PINOUT.md
    Pushed from a clean clone: the OneDrive-hosted .git had dehydrated
    objects (cloud-file provider erroring), so git add/push mmap-failed there.
    [adc.c, adc.h, analog_sensors.c, analog_sensors.h, battery_adc.c, battery_adc.h, battery_flow.c]
2026-08-25 Restore tree truncated by a15083c; r29 remainder 2/2 (adc.h, CONFIG.md, PINOUT.md)
    a15083c was pushed from a clone whose checkout had failed on Windows
    MAX_PATH, so it recorded deletions of files that were never checked out.
    This commit restores every file to its d229643 content and adds the three
    r29 files (PT1000 divider on PA15). Content-identical to the OneDrive
    working tree at 57ef46d.
    [adc.c, adc.h, analog_sensors.c, analog_sensors.h, battery_adc.c, battery_adc.h, battery_flow.c]
2026-08-25 LOGBOOK r29 addendum + CLAUDE.md rule: the OneDrive/.git incident
    Records the dehydrated-.git failure, the bad a15083c commit (never check
    it out) and its 75f8ea4 restoration, and the working rules that follow
    (pin the repo always-local; treat 'mmap failed' as stop-and-fix).
2026-08-25 LOGBOOK §8: TTN application geoenvironode + device provisioning record
2026-08-25 PAYLOAD.md: TTN downlink encoder (goja-safe); first OTAA join recorded
2026-08-25 docs/CONNECTIONS.md: netlist-style connection table for the KiCad drawing
2026-08-27 CM0+: persist LoRaMAC context (DevNonce) after every successful join (LOGBOOK r31)
    After a reset the node could not rejoin TTN: the LoRaWAN 1.0.4 DevNonce
    restarted at 1 (context was only stored on a B3 press) and TTN's Join
    Server rejected every request as a replay (last_dev_nonce 18). Hook
    StoreContext into OnJoinRequest on success. Also reworded the CM4's
    inherited 'radio busy / duty cycle' message. Diagnostic recipe (TTN JS
    last_dev_nonce + gateway connection stats via API) recorded.
    [lora_app.c, main.c]
2026-08-27 Add Streamlit dashboard for remote node control over TTN (verified)
    Full-stack single-file Streamlit app (dashboard/app.py) to monitor and
    remotely control EnviroNode-WL55 through The Things Network:
    - Status: latest decoded reading, link/join/gateway state
    - Live data: time-series charts + CSV export from the TTN Storage API
    - Control: sensor set + interval, uplink-now, reset rain, reboot, wind
    offset, calibration - all sent as Class-A downlinks (config strings +
    FPort-10 binary commands), matching docs/PAYLOAD.md and docs/CONFIG.md
    - Advanced: raw config strings, raw bytes, set_enable mask, queue view/clear
    No secret hard-coded (sidebar / env / st.secrets). Packaging: install.bat,
    run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
2026-08-27 Dashboard: minimal emoji-free redesign + battery percentage
    - Remove every emoji (UI, buttons, tabs, HF Space card); modern minimal
    chrome (hidden menu/footer/header, constrained width, tighter type).
    - Battery state-of-charge % from pack voltage using the node's own 1S
    Li-ion curve (soc_from_voltage; 3.30 V = 0%, 4.20 V = 100% - floors on
    the real range, never at 0 V), shown as a headline metric + progress bar
    and a Data-tab chart. Self-test extended.
    - Status tab condensed to 4 headline metrics with details in expanders.
    Verified: --selftest (with + without deps), Streamlit AppTest full render
    (no exception; Battery metric renders e.g. '36 %' from 3.74 V).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
2026-08-27 Dashboard: remove API key + connection fields from the UI
    The sidebar pre-filled the TTN API key into a password input, which a viewer
    could reveal in the browser. Read region/app/device/gateway/key from Streamlit
    secrets or environment variables only - never from a UI field. The sidebar now
    shows just non-secret context (device @ app) and history depth; if TTN_API_KEY
    is unset the app fails safe with an error telling the deployer to set the Space
    secret. SECRETS.txt and Help updated (no sidebar-entry option).
    Verified: --selftest PASS; AppTest with the secret renders (only Advanced-tab
    raw fields remain as inputs, no key field); clean-dir AppTest with no config
    stops with the key-missing e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
