mabiran/environode-wl55/(notices)

Notices in the files:
CM4/EnviroNode_CM4/Core/WL55JC1/Inc/i2c.h:
Copyright (c) 2025 STMicroelectronics.
All rights reserved.
CM0/EnviroNode_CM0PLUS/Core/Inc/sys_conf.h:
Copyright (c) 2021 STMicroelectronics.
